bogwee/ProjetArduino/Lucah Patel/rapport_séance8.md

Avancement :
  - Le projet et quasi-fini, en termes de fonctionnement, il est fini 
  - Arrangement des câbles, montage des servomoteurs et le tube

Taches effectuées:
  - Regroupement de tous les codes pour rendre un code final
  - modélisation d'une dernière pièce pour couvrir les files
  - Changement de la disposition de la manette :
      Screenshot_20240222_182015_Bluetooth Electronics

        - Bouton vert : avancer
        - Bouton rouge : arrêter
        - Bouton bleu : tirer (actionner les moteurs pour tirer)
        - Bouton jaune : stopper les moteurs pour tirer
        - Bouton arrière, droite, gauche, arrière droite, arrière gauche
        - Slider 1 : servomoteur
        - Slider 2 : servomoteur

  - on a testé pour insérer un module permettant de déposer al balle sur les moteurs du tube, mais cela n'a pas fonctionner.
