bogwee/ProjetArduino/Lucah Patel/rapport_séance6.md

Avancement :
  - Arrangement des fils.
  - Peinture du tank.
  - Ajout d'un Breadbord pour les fils en extra.
  - Utilisation de 3 piles 9900mA LI-ION rechargeable pour l'alimentation.

Tache éffectuer :
  - Modélisation en 3D d'une pièce qui permet de pousser la balle sur les moteurs dans le tube (pusheur) :

      

      Rayon du demi-cercle ~ 25mm permettant de s'enserrer dans le tube.
      Longueur du pusheur ~40mm pour que ce soit manipulable facilement a la main

  - Déconstruction entière du tank pour peindre le squelette ainsi que le tube, les support des servomoteur, etc...
  - Arrangement des fils pour qu'il ne traîne pas, réduire la taille pour qu'il ait la longueur parfaite entre chaque connexion.
  - Manipulation avec les moteurs pour le tube, afin de trouver la bonne distance pour laquelle il envoie la balle le plus loin possible.
  - Ajout de colle sur les disques qui seront en contact avec la balle pour augmenter la friction afin de transfert plus d'énergie dans la balle.
  - Problème avec le dispositif Bluetooth, le composant hc-06 n'envoyait plus les donne à notre téléphone.
  - Recherche sur la manipulation des servomoteurs, utilisation de la librairie "Servo.h".
