bogwee/ProjetArduino/Lucah Patel/rapport_séance5.md

Avancement :
  - Tube Projectile avec moteur qui fonctionne
  - Tank qui fonctionne avec les pile alimenté par 12V
  - Ajout d'un switch pour alimenter la carte et les moteurs
  - Manette (téléphone) connectée par Bluetooth

Tache Éffecteur :
  - Assemblage des moteurs 5V pour lancer les projectiles.
  - Script en entier qui permet de faire avance le tank, tourner (à droite ou à gauche) et d'arrêter avec manipulation par Bluetooth.
  - Ajustements des espaces entre les composantes de la tourelle.
  - Création d'un deuxième script pour tester les moteurs du projectile.
  - Re-Modelisation du tube projectile :

    

    

    

    - Diamètre de taille de la balle
    - il y a un trou au-dessus pour insérer la balle éventuellement ce-ci va être complété.
    - les rectangles sur le côté sont pour les moteurs pour propulser la balle.
    - Et enfin, à l'arrière, il a un demi-troue pour éventuellement lorsque la tourelle vise vers le haut la balle va être reposé sur l'arrière du tube donc on insérera un petit piston pour que les balles atteigne les moteurs.
