bogwee/ProjetArduino/Lucah Patel/rapport_séance4.md

Avancement : 
  - Mise en marche du tank
  - connectin par bleutooth
  - modelisation de piece

Effecteur :
  - Mettre en marche le tank avec l'alimentation de 12V des piles
  - Avancement sur le script pour le Bluetooth appareil hc-06 connexion avec le téléphone via Bluetooth éléctronics
  - Quelques débogages et ajustement sur le code qui a pris un peu beaucoup de temps.
  - Remodélisation des Pièces pour le tube, le support du tube (pas encore finis):
     - Repris les piece du tube et du support du tube pour créée une seule piece ayant un troue pour les projectiles avec le reservoire

- Beaucoup d'ajustement et de réglage
