bogwee/ProjetArduino/Lucah Patel/rapport_séance3.md

Avancement :
  - Emplacement définitif de tout les composant de la base du tank (pont H, Batterie fournissant 12V, carte Arduino, servomoteur pour la tourelle).
  - Réalisation des pièces pour la tourelle sur Onshape.

Effectuer :
  - Modélisation de 2 pièces sur Onshape pour la tourelle,

    Tube projectile :
    
    
Prise de mesure de diamètre des balle qui vont être utilisé comme projectile.
Prise de mesure du tank.
Prises de mesure d'un tube projectile d'un anvian projet arduino.
Comparaisons des valeurs pour rendre un tube projectile qui a une taille proportionnelle au tank et assez large pour que le projectile passe à travers avec un minimum de frottement possible sur les parois.

    Support du tube :
    
    
Soudage de moteur pour le tube projectile.
Mise en place des moteur et d'un disque qui permettra de propulser la balle à travers le tube.
Découpage d'un ancien support de moteur provenant d'un ancien projet pour utiliser les partie précise pour les modifier et les ajouter dans le nôtre.
