bogwee/ProjetArduino/Lucah Patel/rapport_séance2.md

Avancement:
  - Rassemblement des pièces pour la tourelle.
  - Emplacement de chaque pièce sur le chassis, permettant d'avoir un tank sans fil qui traine et esthétiquement propre.
  - Systeme be batterie founissant 12V au moteur.

Rapport:
  - Utilisation d'un circuit en serie qui utilise 8 pile de 1.5V pour fournir 12V au moteur.
  - Soudage de ce circuit et barnchement au chassis.
  - Rassemblent des pièces pour la tourelle:
        Projectile (petite balle de diametre: (2.3+-0.1)cm).
        Tube dans lequlle les projectille vont etre propulsée (diametre: (2.5+-0.1)cm, longueur: (18+-1)cm).
        2 moteur separé de (2+-0.1)cm tournant dans des sens opposées attaché a 2 disque semi-lisse pour propulsé les projectiles.
        Soudage des fils d'alimentations des moteurs qui seront ensuite connecter a la carte arduino.
        Assemblage du systeme permatant de faire bouger la tourelle sur 2 axe (rotation sur l'axe z et selon l'axe x), effectuer avec 2 servo-moteur et 2 pièces permettant d'empiler les moteur l'une sur l'autre.
  - Modalisaation via l'application OnShape en 3D du la tourelle.
