bogwee/ProjetArduino/Lucah Patel/rapport_séance1.md

Avancement : 
 - cablage du chassis avec pont H connecter sur 2 moteur 12V
 - Programme permettant d'avancer de reculer de tourner selon les direction (par PWM)
 - Recherche sur la télécommande (sur telephone par bleutooth ou a travers une manette

Rapport : 

Creation d'un scripts prenant les differents pattes du pont H (IN1, IN2, IN3, IN4), variants leur valeur PWM pour faire avancer la base du tank, etablir les bonne vitesse pour avancer, accélérer, reculer, tourner
Recherche sur Internet les differents programme permettant de manipuler une carte arduino a travers un joystick.
Branchement du transmetteur bleutooth et creation du debut du scripts pour regler le mouvement sur téléphone.
Creation du panel sur Bleutooth electronincs avec: 
  - un Pad pour le mouvement (avant, arrier, droite, gauche)
  - un Slider pour gerer les vitesses (PWM qui sera appliquer sur le ou les moteur selon si on tourne ou pas)
  - un bouton pour arreter le tank immédiatement.
