bogwee/ProjetArduino/(commit log)

2023-12-06 Update README.md
    des
2023-12-06 Update README.md
    cahier des charges
2023-12-06 Update README.md
    digramme de grantt
2024-01-24 Create tube.ino
    moteur tube
2024-02-08 Create servo.ino
    ke ke ke ke kode sss sss sss serv v v ve veve vomoteur
2024-02-22 Update tube.ino
    update
